GreatApo/BC250_ESP32_ATX_PSU/img/webUI_PC_password.JPG

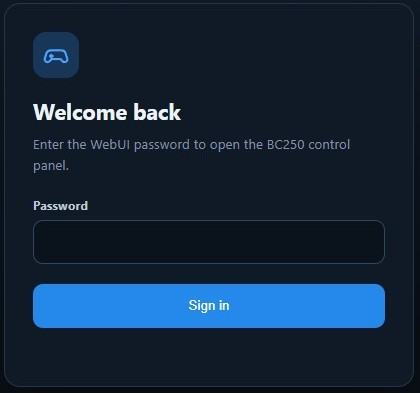
img/webUI_PC_password.JPG
