GreatApo/BC250_ESP32_ATX_PSU/(commit log)

2026-07-16 Arduino Nano as USB-to-TTL adapter instructions
2026-07-16 Updated pin comments
2026-07-17 Fixed AP disconnect issue, redesigned UI portal and added WiFi setup
    [BC250_ESP32_ATX_PSU.ino]
2026-07-18 Added Android and IPhone web shortcut icons
    [BC250_ESP32_ATX_PSU.ino]
2026-08-01 Changed power button to common PC behaviour
